AitNev/EnigmaMachine/Img/Measurements.jpg

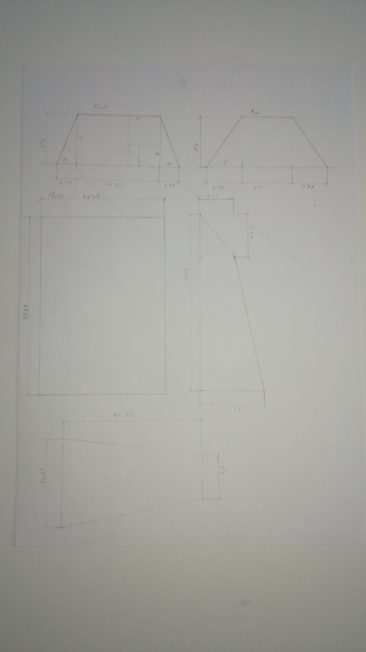
Img/Measurements.jpg
