AitNev/EnigmaMachine/README.md

# EnigmaMachine

It uses an Arduino for controlling 8x8 led matrix with shift registers to represent the decoded word and 4 digits of a 7 segment display for representing the position of the first 3 rottors and if it is in editting mode, driven by the shift registers. The input is given by an Android app that connects to the hc06
