AitNev/EnigmaMachine/Img/Doc1.jpg

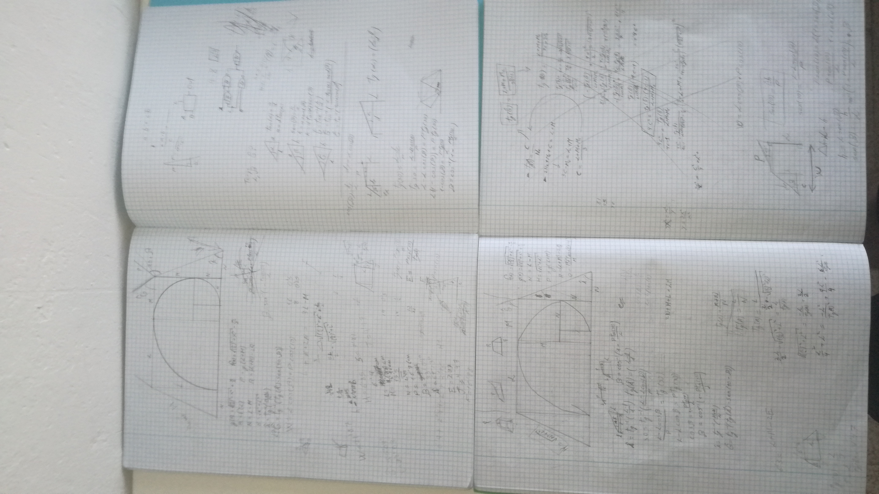
Img/Doc1.jpg
