AitNev/EnigmaMachine/Img/Doc2.jpg

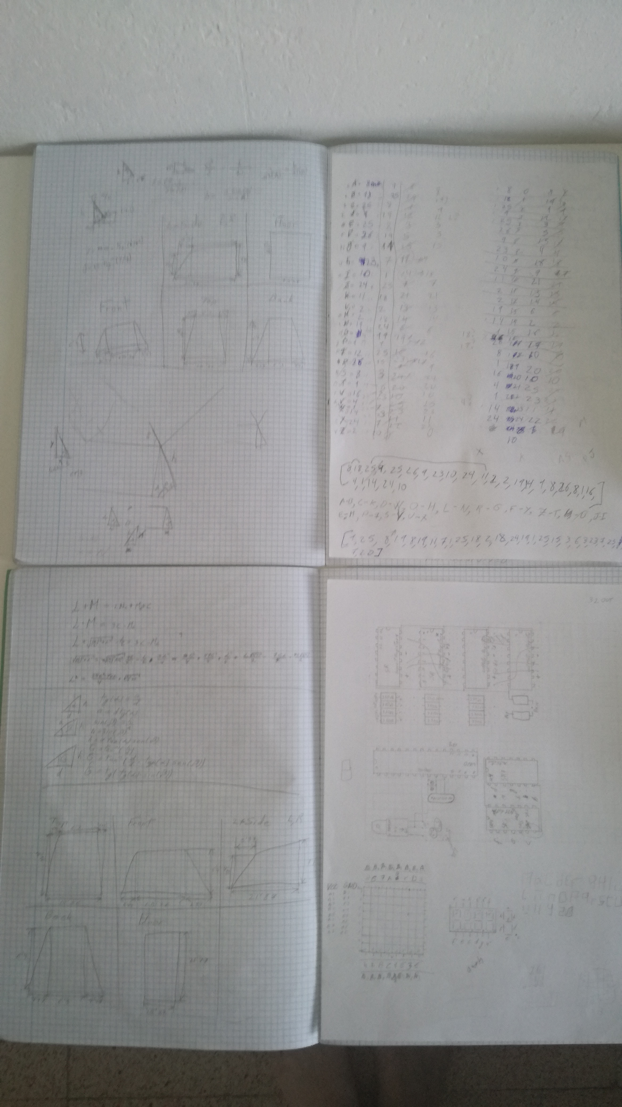
Img/Doc2.jpg
