AitNev/EnigmaMachine/Img/Preview.jpg

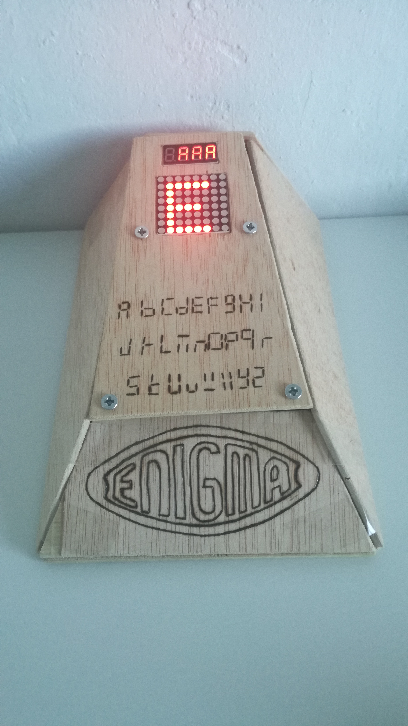
Img/Preview.jpg
