AitNev/EnigmaMachine/Img/WoodCutLayout.jpg

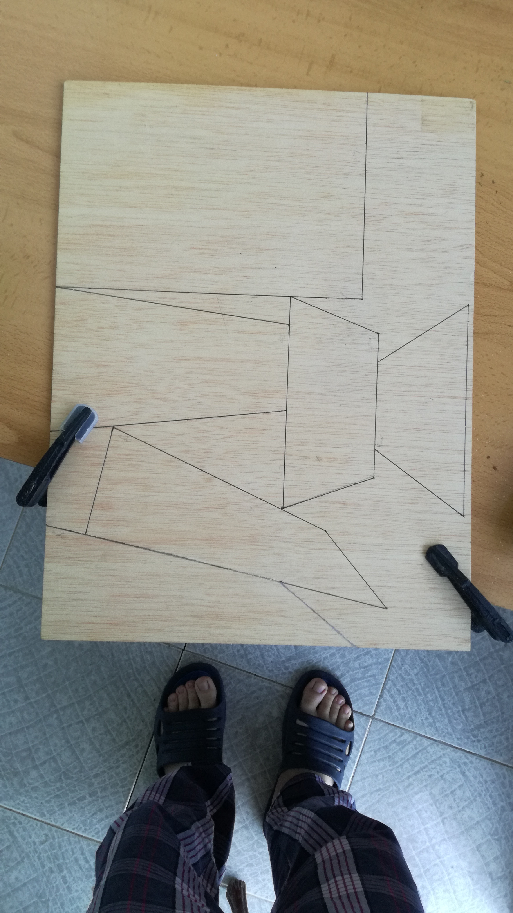
Img/WoodCutLayout.jpg
