AitNev/EnigmaMachine/(list of files, cad)

Other CAD files:
Blender/Enigma3D.blend
Blender/EnigmaModel.blend
